Ateeq-ur-Rehman04/2-Wheeled_Self-Balancing_Robot/Interface/README.md

Software interfacing with the main code for live telemetry.
