Ateeq-ur-Rehman04/2-Wheeled_Self-Balancing_Robot/Robot Chassis/Column Structure New.STL

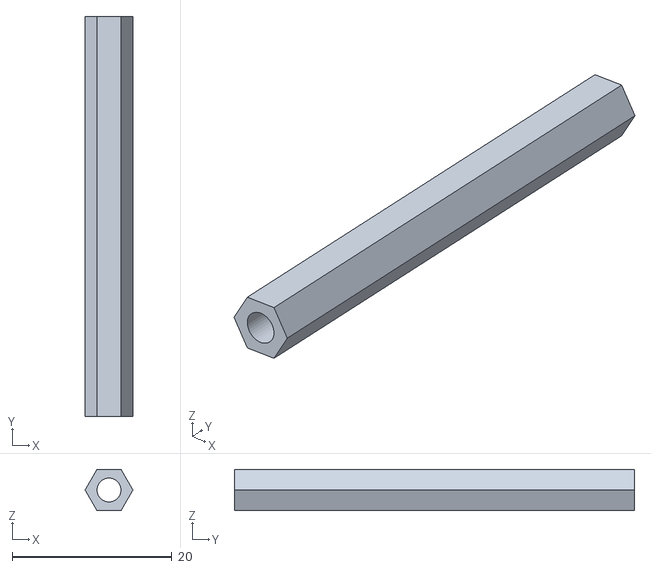
[picture p20: CAD file, 2026-04-23]
Robot Chassis/Column Structure New.STL
6.00 x 50.1 x 5.20
